brunomatic/attiny85_soap/EagleCAD/attiny85_soap.brd

## EAGLE design EagleCAD/attiny85_soap.brd (2016-12-17)

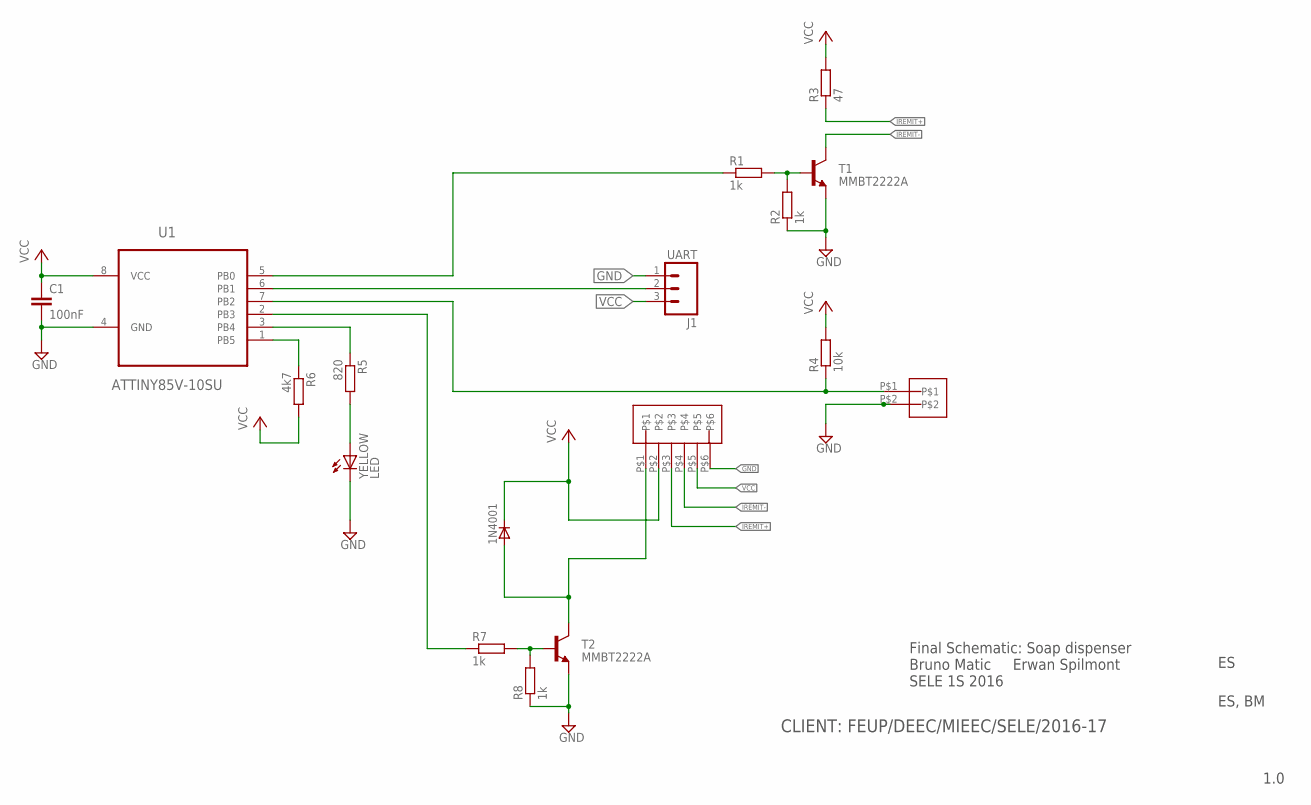
[picture p1: schematic attiny85_soap.sch]

Parts:
1N4001: SM400GENERIC; MELF-MLL41_DO213AB
C1: 100nF; C0603
IRDET_CON: 2_PIN_JST-XH
J1: UART; 1X03_NO_SILK
R1, R2, R7, R8: 1k; R0805
R3: 47; R0805
R4: 10k; R0805
R5: 820; R0805
R6: 4k7; R0805
T1, T2: MMBT2222A; SOT23-BEC
U1: ATTINY85V-10SU; SOIC127P798X216-8N
U$1: 6_PIN_JST-XH
YELLOW: LED; LED_LD260

Connections:
GND: C1.2, IRDET_CON.P$2, J1.1, R2.1, R8.1, T1.E, T2.E, U1.4 (GND), U$1.P$6, YELLOW.K (C)
IREMIT+: R3.1, U$1.P$3
IREMIT-: T1.C, U$1.P$4
IRRC+: IRDET_CON.P$1, R4.1, U1.7 (PB2)
unnamed: R6.1, U1.1 (PB5)
unnamed: R1.2, R2.2, T1.B
unnamed: R7.1, U1.2 (PB3)
unnamed: J1.2, U1.6 (PB1)
unnamed: R7.2, R8.2, T2.B
unnamed: R5.1, U1.3 (PB4)
unnamed: R1.1, U1.5 (PB0)
unnamed: R5.2, YELLOW.A
PUMP-: 1N4001.A, T2.C, U$1.P$1
VCC: 1N4001.C, C1.1, J1.3, R3.2, R4.2, R6.2, U1.8 (VCC), U$1.P$2, U$1.P$5

Notes on the sheet:
Final Schematic: Soap dispenser Bruno Matic Erwan Spilmont SELE 1S 2016
1.0
ES, BM
CLIENT: FEUP/DEEC/MIEEC/SELE/2016-17

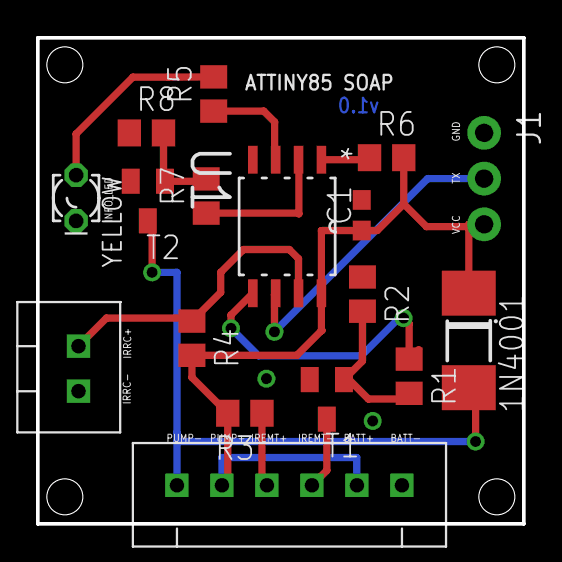
[picture p2: board attiny85_soap.brd from above]

Board: 2 copper layers, 27.0 x 27.0 mm, 17 parts (0 on the bottom side), 14 nets.
