brunomatic/attiny85_soap/errors.h

/*
 * errors.h
 *
 *	All error codes are defined here.
 *
 *  Created on: 10. pro 2016.
 *      Author: Bruno
 */

#ifndef ERRORS_H_
#define ERRORS_H_

/* No error detected */
#define NO_ERROR 1

/* Battery low error */
#define BATT_LOW 10

/* IR gate error */
#define IR_ERR 11

/* Flash memory CRC error */
#define FLASH_ERR 12

/* SRAM memory error */
#define SRAM_ERR 13

#endif /* ERRORS_H_ */
