brunomatic/attiny85_soap/tests.h

/*
 * tests.h
 *
 *  Created on: 8. pro 2016.
 *      Author: Bruno
 */

#ifndef TESTS_H_
#define TESTS_H_

void test_info_led(void);
uint8_t test_IR(void);
uint8_t test_flash(void);
uint8_t test_sram(void);
uint8_t test_battery(void);
uint8_t system_self_test(void);

#endif /* TESTS_H_ */
