brunomatic/attiny85_soap/(commit log)

2016-12-10 Added basic memory tests; CRC in config not correct; restructured code
    [config.h, eeprom_control.c, eeprom_control.h, errors.h, main.c, tests.c, tests.h, timer.c]
2016-12-13 Commenting the code and some fixes
    [battery.c, calibration.c, config.h, eeprom_control.c, eeprom_control.h, errors.h, init_tests.c, ir_gate.c]
2016-12-17 Schematics and board
    [attiny85_soap.brd, attiny85_soap.sch]
